saklanihetal/SAGE-Vision/(commit log)

2026-06-03 perf(test): add benchmark script for baseline CV pipeline performance
    Introduce a testing script to run the computer vision pipeline
    without our adaptive edge hardware integration.
    This establishes the unoptimized baseline for CPU temperature
    and power consumption, allowing future runs to quantify the exact
    efficiency gains introduced by our device.
2026-06-03 feat: add analytical plotting code to compare sensor-driven vs baseline mode
    - Add visualization script comparing and .
    - Generate comparative graphs for four core metrics: scene-wise accuracy, latency, CPU utilization, and CPU heating.
    - Quantify resource and thermal savings achieved by the adaptive loop against an unthrottled baseline.
2026-06-03 fix(analysis): correct data alignment and statistics skew in comparative plots
    - Fix chronological x-axis matching to align asynchronous data rates across uneven log files.
    - Filter out standby latency metrics to prevent artificial statistical skew on the sensor-driven system.
    - Correct regex string parsing for scene-wise accuracy calculation from the log columns, and tracking accuracy by keeping ground truth data separately.
    - Ensure proper file handling for both and .
2026-06-03 fix: resolve serial mismatch, pathing bugs, and dependency conflicts
    CRITICAL FIXES:
    - rpi_edge/pi_edge_node.py: Swapped and CSV parsing for a packed 7-byte binary struct unpack () to match ESP32 firmware telemetry. This fixes an infinite block that kept the vision pipeline permanently in standby.
    - rpi_edge/pi_edge_node.py: Replaced hardcoded serial port with a glob-based auto-detection helper to support devices.
    MODERATE FIXES:
    - rpi_edge/requirements.txt: Dropped standalone to prevent package and import conflicts with on aarch64.
    - host_laptop/requirements.txt: Created missing file with , , and to fix ModuleNotFoundError in visualization scripts.
    - test/test_baseline_edge.py: Patch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
    [pi_edge_node.py]
2026-06-04 docs: add initial project documentation
    Add comprehensive documentation files to guide project setup, hardware configuration, and validation.
    - Add README.md for the general project overview
    - Add SETUP.md for installation instructions
    - Add HARDWARE_CONNECTIONS.md for pinouts and wiring schematics
    - Add TESTING.md for testing and benchmarking
2026-06-05 refactor: replace linear if-else logic with 5-state FSM
    Replaces the legacy linear condition checks with a deterministic, five-state finite state machine (Sleep, Standby, Active-Lo, Active-Hi, Watchdog) to optimize power and tracking accuracy.
    - Adds 40cm distance and 70-count LDR hysteresis to eliminate boundary thrashing.
    - Implements a 5-sample circular buffer rolling median filter for ultrasonic noise.
    - Enforces fixed preprocessing order: Full-Frame -> CLAHE -> Resize -> YOLOv8n.
    - Embeds an independent hardware watchdog override for serial/packet failures.
    [pi_edge_node.py]
2026-06-12 refactor(logging): Replace CSV logging with terminal logging
    Remove the CSV file logging logic to streamline output.
    All log messages are now directed exclusively to the terminal
    standard output for real-time monitoring.
    [pi_edge_node.py]
2026-06-15 refactor(inference): implement dual-resolution YOLO pipelines for fixed-shape INT8 compatibility
    - Split the single YOLO inference pipeline into two distinct, dedicated resolution models.
    - Address INT8 quantization constraints that prevent model input dimensions from being modified dynamically at runtime.
    - Remove redundant CSV logging code and files.
    - Update frame processing to route directly to the corresponding static-shape models of sizes 640*640 and 320*320.
    [pi_edge_node.py, yolo_tflite.py]
2026-06-15 refactor(sensor): migrate sensor reading from ESP32 to Raspberry Pi via pigpio and switch to digital LDR
    - Change sensor data acquisition from external ESP32 board directly to Raspberry Pi.
    - Replace the analog LDR with a digital binary (active Low) LDR sensor.
    - Trigger CLAHE enhancement using a simple boolean flag from the binary LDR instead of the old analog range-based method.
    - Maintain identical architectural engineering and sensor data processing logic for the remaining pipeline.
    [pi_edge_node.py]
2026-06-15 docs(sensor): update documentation for Raspberry Pi migration and digital LDR logic
    - Update schematics, setup and pin descriptions for the direct integration with Raspberry Pi.
    - Update appropriate docs to account for the new digital LDR sensor
2026-06-16 refactor(telemetry): replace network logging with terminal logging and add future tracking placeholders
    - Remove remote network telemetry logging pipeline.
    - Implement local terminal stdout logging for real-time diagnostics.
    - Add explicit placeholder methods for tracking system power consumption, once sensor is integrated.
    - Add stub functions to handle future cloud data transmission logic.
    [pi_edge_node.py]
2026-06-18 feat(sensor): implement exit wind-down logic and sensor flap mitigations
    - Add an explicit wind-down state machine transition for room exit events: detect ACTIVE-HI to ACTIVE-LO transition, wait ~2 seconds, maintain ACTIVE-LO for ~10 seconds with zero high-power spikes, then transition to SLEEP. Continuous presence/proximity holds the current active state without cycling.
    - Implement state-transition debounce to mitigate Flap-A: require a threshold crossing to hold for TRANSITION_CONFIRM_N consecutive FSM ticks and verify the current state meets MIN_DWELL_S before committing a HI/LO switch.
    - Implement multipath spike rejection: drop single-frame distance jumps exceeding MAX_PLAUSIBLE_JUMP_C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
2026-06-22 refactor(sensor): standardize edge debouncing with time-based TransitionGate
    Introduce a reusable TransitionGate class in pi_edge_node.py to replace ad-hoc _hilo helpers with time-based debouncing (hold_s and dwell_s). This eliminates tick-count discrepancies caused by variable loop pacing (e.g., 0.01s vs 0.4s).
    Apply TransitionGate to stabilize three critical flicker edges:
    - WATCHDOG: Require sonar health for 1.5s hold + 1.0s dwell to prevent sub-second flapping.
    - SLEEP wake: Confirm wake over 0.5s and implement 300cm/350cm distance hysteresis.
    - HI↔LO pacing: Route both directions through the gate to bound oscillation to ≥1.5s.
    Adjust SLEEP loop pacing from 1.0s to 0.5s to ensure w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
    [pi_edge_node.py]
2026-06-24 feat(power measurement): integrate INA219 power sensing and update hardware docs
    - Implement read_power_w via I2C with fallback mechanism
    - Add pi-ina219 dependency to requirements.txt
    - Mirror power metrics in baseline test harness
    - Rewrite hardware doc with new changes
2026-06-25 Remove old ESP32 sensor node logic
2026-06-25 feat(rpi_edge): add non-blocking ThingSpeak cloud telemetry sink
    - Add background worker thread to upload telemetry every 20s
    - Support dotenv loading for THINGSPEAK_API_KEY
    - Add opt-in --cloud CLI flag, verification guards, and dependency
    - Document configuration and setup steps in README.md and SETUP.md
2026-06-25 feat(snapshots): add opt-in detection snapshot capture
    Save a JPEG to ./snapshots/ when a person is detected, behind a
    --snapshots flag (off by default, so the node stays fully offline).
    - maybe_queue_snapshot(): cooldown-gated; picks the highest-confidence
    qualifying detection and hands a frame copy to a bounded queue
    - snapshot_worker(): pinned to core 0, JPEG-encodes off the vision
    thread, writes the file (filename carries ts/class/conf/state), and
    enforces a ring-buffer file cap so the SD card can't fill
    - bounded queue with drop-oldest so a slow disk never stalls the FSM
    - git-ignore the snapshots/ directory
    [pi_edge_node.py]
2026-06-25 test: add telemetry log analyser and rewrite benchmarking procedure
    - add test/analyze_log.py: parse a captured telemetry log into per-run
    metrics (mean CPU, peak temp, active-frame latency, time-weighted
    power/energy, J/detection, time-in-state); handles both the baseline
    and adaptive line formats and treats '-- W'/'---' as missing
    - TESTING.md: drop the stale plot_comparison.py/CSV references, explain
    the ee capture, and document the analyze_log.py flow with an
    objective->metric mapping and a results table
    - require --cloud and --snapshots OFF during measured runs (their
    Wi-Fi/SD activity would bias the INA219 whole-Pi power reading)
2026-06-25 docs: rewrite README and engineering log; refresh setup guide
    - README: restructure around the finalised implementation write-up
    (system overview, hardware tables, presence fusion, FSM, anti-flap,
    inference engine, concurrency, telemetry, power) with diagram refs
    - SETUP: fix the stale boot-message output and the phase cross-refs left
    by the ESP32-phase removal; add the --snapshots run option
2026-06-26 refactor(loop pace): refactor loop pace from 0.01s to 0.1s to increase power consumption in ACTIVE-LO
2026-06-26 feat(fsm): wake into low-res first + measure wake latency
    On wake, STANDBY now always enters ACTIVE-LO (320) regardless of distance,
    instead of selecting 640 by range -- so the first frames after a wake are
    captured immediately at low resolution and a far subject is escalated to
    ACTIVE-HI by the normal gate afterwards. This hides the ~0.7s first-640-frame
    latency behind responsive low-res frames, cutting time-to-first-detection by
    ~0.57s (~1.7s -> ~1.1s for a distant subject).
    - stamp the wake signal in SLEEP; print a [WAKE] log line reporting ms to the
    first post-wake inference
    - analyze_log.py: parse and report wake latency (mean/min/max)
    - README: update the STANDBY/ACTIVE-LO states an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
2026-06-26 docs: align docs with recent fixes; drop throttling for avg temperature
    Reflect the model re-export, wake-into-low-res-first, the ACTIVE-LO fps cap,
    and the shift from throttle events to average / steady-state temperature.
    - ENGINEERING_LOG: add P8 (the low-power-state-was-not-low-power debugging
    story -- ACTIVE-LO flat-out pacing, no-absence test, broken control model,
    and the fixes); update the state-entry table (STANDBY always -> ACTIVE-LO),
    the vision-vote note, and mark the 640 INT8 model re-exported
    - TESTING: reframe the thermal objective to average/steady-state temperature
    (no throttle events); add a methodology note (frame-rate cap + absence
    requirement); expand the resul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
2026-06-26 feat(presence): evidence-weighted tiered presence (vision arbitrates)
    Replace the flat OR presence fusion with a tiered scheme: keep-awake stays
    an OR (any signal sustains the awake state), but the expensive ACTIVE-HI
    state is gated on *confirmed* evidence, since the signals are not equally
    trustworthy. A spurious PIR (sunlight/HVAC) or static furniture within range
    no longer holds HI on an empty scene.
    - vision (confident person, >= VISION_VOTE_CONF) confirms a person and holds
    HI; it is the arbiter
    - proximity unlocks HI only as a time-limited probe (PROXIMITY_PROBE_S):
    run 640 to look, demote to the LO probe if vision stays silent
    - PIR alone wakes + keeps a cheap LO probe, never jus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
    [pi_edge_node.py]
2026-06-26 docs: document self-correcting recovery from a probe demotion
    The proximity-probe demotion is not terminal: the LO probe keeps running
    inference, so a (re-)entering person is re-detected by the 320 vision vote
    and re-escalated to HI. Add the re-entry edge case (P9) and narrow the
    limitation to the neither-model-detects + masked-proximity corner case.
    - ENGINEERING_LOG: P9 worked edge cases + reference edge cases + limitation
    - README: note the self-correcting recovery in the presence section
2026-06-26 fix(CLAHE): switch to active low ldr settings
    [pi_edge_node.py]
2026-07-03 refactor(power): drop INA219 auto-logging for a manual inline USB-C meter
    Whole-Pi power is now measured with a standalone inline USB-C power meter
    read by hand off its display, so all in-software power logging is removed:
    - pi_edge_node: delete read_power_w()/INA219 config, drop power_w from both
    telemetry records, the terminal pwr column, and the GUI HUD; remove the
    ThingSpeak power field and renumber cloud fields (1=latency, 2=temp, 3=dist)
    - test_baseline_edge: mirror the same removals so the control stays field-matched
    - analyze_log: drop pwr parsing and the mean-power/energy-J/J-per-detection stats
    - requirements: remove pi-ina219
    - docs: replace the soldered INA219 rig (HARDWARE_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
    [pi_edge_node.py]
2026-07-05 fix(presence): sonar votes on background deviation, not absolute distance
    An absolute distance < PRESENCE_DISTANCE_CM test never clears because a
    rangef
    fix(presence): sonar votes on background deviation, not absolute distance
    An absolute distance < PRESENCE_DISTANCE_CM test never clears because a
    rangefinder always sees the room (wall/furniture/self-trigger). A stuck
    ~9cm phantom reading pinned last_presence_epoch every loop, so quiet_for
    never reached PRESENCE_TIMEOUT_S and the node never left ACTIVE-LO for
    SLEEP.
    Replace it with range-domain background subtraction: learn
    sonar_background_cm (seeded on first read, slow EMA) and vote presence
    only on |distance - background| > SONAR_BG_DEL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
    [pi_edge_node.py]
